pacman314159/3D-Printed-Crane-System-HCMUT/AS2071_CC01_Group_04 (1).pdf

## Ho Chi Minh City of Technology

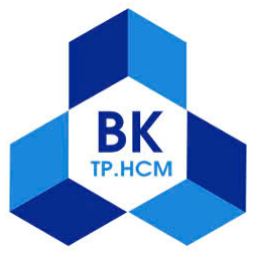
[picture p1: figure]

## Engineering Mechanics – AS2071

## Lecturer: Ph.D. Pham Toan Thang

# Design and Modelize Tower Crane

## Group 04 – CC01

No | STUDENT ID | NAME | TASK | SIGN
1 | 2452911 | Nguyen Quy Hao Nhien | Electrical Design
2 | 2452389 | Luu Gia Huy | Mechanical Design
3 | 2452318 | Nguyen Cat Gia Han | Transmission Design
4 | 2453304 | Hoang Trong Tri | Mechanical Design
5 | 2453259 | Nguyen Duc Toan (LD) | Report Writer
6 | 2452696 | Nguyen Thanh Long | Control Design
7 | 2450001 | Nguyen Minh Quoc Anh | Report Writer

## Dec 01st

, 2025

# Contents

Introduction | 1
1 Mechanism Overview | 2
2 Mechanical Design | 12
3 Transmission Design | 16

i

4 Electrical & Control Design | 24

ii

5 Testing & Evaluation | 35
Conclusion and Evaluation | 39
Reference | 41

iii

# List of Figures

1.1 Tower Crane Structure | | 2
1.2 Base Support (Front view) | | 3
1.3 Base Support (Side view) | | 3
1.4 Tower Section | | 4
1.5 Slewing Ring | | 4
1.6 Operator Cab | | 5
1.7 Main Jib | | 5
1.8 Trolley | | 6
1.9 Hook Block | | 6
1.10 Counter Jib | | 6
1.11 Counterweight | | 7
1.12 Pandent Bars | | 8
1.13 Tower Top | | 8
1.14 Transmission System | | 8
1.15 Slewing Mechanism | 10
2.1 Overview of Mechanical Design | 14
3.1 Visualization of Transmission System | 16
3.2 Visualization of Hoisting Mechanism | 18
3.3 Visualization of Trolley Mechanism | 20
3.4 Visualization of Servo-to-Drum Transmission System | 21
4.1 Electrical-Control Overview 1 | 24
4.2 Electrical-Control Overview 2 | 25
4.3 Electrical-Control Diagram | 25

iv

4.4 Power Unit | 27

v

# Introduction

Tower cranes are indispensable equipment in modern construction, serving as the back-

bone of high-rise building projects and large-scale infrastructure development worldwide. These

machines represent a remarkable achievement in mechanical engineering, combining sophisti-

cated structural design, power transmission systems, and advanced control technology to safely

lift heavy loads at significant heights with precision and efficiency.

The tower crane is a massive vertical lifting structure characterized by its exceptional

reach, high load capacity, and operational stability. A typical tower crane consists of nine major

assemblies: base support, lattice steel tower, rotating turntable, operator’s cabin, main jib,

counter jib, counterweight masses, trolley-and-hook system, and tie cables. These components

work synergistically to achieve safe lifting operations. The design reflects a deep understanding

of mechanical principles, particularly moment equilibrium, force distribution, and structural

stability—concepts fundamental to engineering mechanics.

Understanding the structure and operating principles of tower cranes provides valuable

insights into applied mechanics and mechatronics engineering. By studying how loads are

distributed, how moments are balanced, and how forces are transmitted through mechanical

systems, engineers gain practical knowledge applicable to numerous engineering domains. This

project demonstrates how classical mechanics principles are applied to solve complex engineering

challenges in real-world lifting equipment.

# Chapter 1

# Mechanism Overview

The tower crane is a large-scale lifting and lowering equipment widely used in the con-

struction of high-rise buildings, bridges, roads, and major infrastructure projects. This type of

equipment is capable of extended reach, lifting heavy loads at great heights, while maintaining

stability and operational precision. Studying the structure and mechanical principles of tower

cranes helps clarify how loads are distributed, moments are balanced, and forces are transmit-

ted. This knowledge is essential for modeling, designing, and simulating structures in applied

mechanics and mechatronics engineering.

A typical tower crane consists of nine main assemblies: base support, tower section,

turntable, operator’s cab, main jib, trolley and hook block, counter jib, counterweight, and tie

cables.

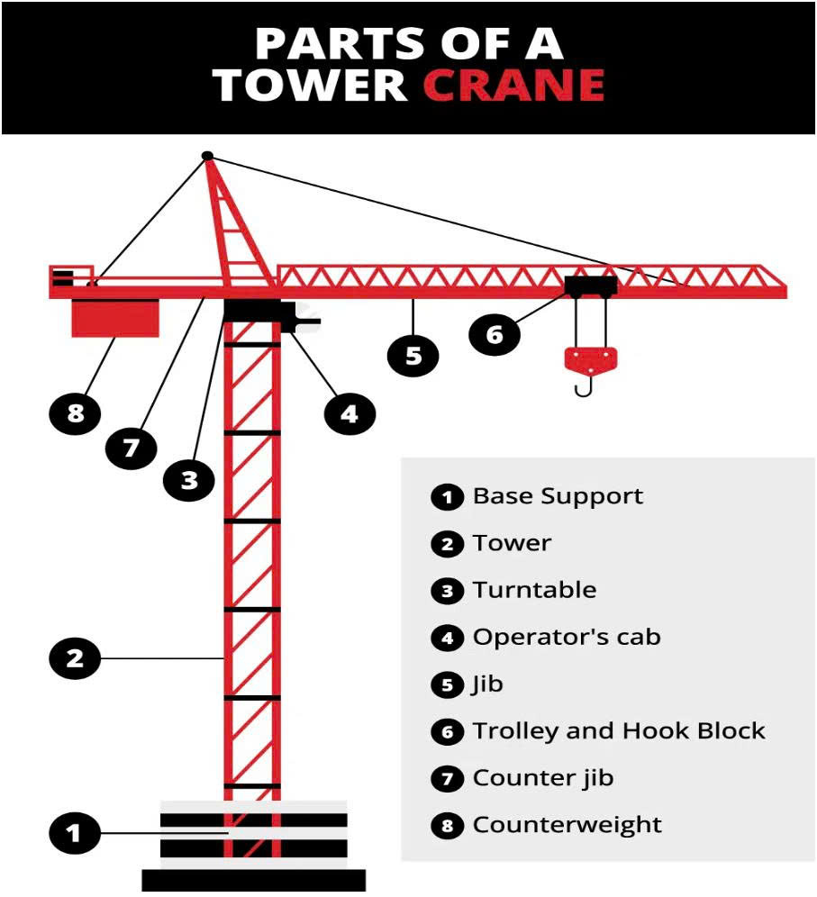
[picture p2: figure]

Figure 1.1: Tower Crane Structure

## 1.1 Tower Crane Structure

### 1.1.1 Base Support

The base support is the foundation component that bears the entire load of the tower

crane and is firmly anchored to reinforced concrete foundations. The structure typically consists

of a welded steel frame arranged in a grid or flange configuration with high-strength bolted

connections. This design distributes compressive forces and bending moments to the ground,

ensuring overall system stability. The choice of a welded lattice structure reduces weight while

maintaining high rigidity, facilitating assembly and disassembly.

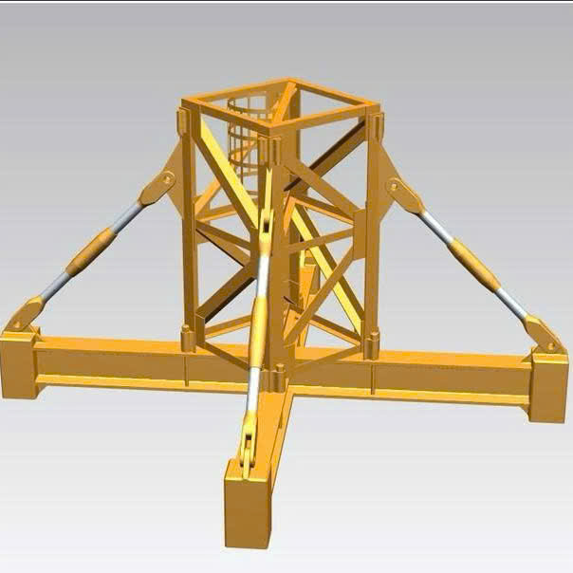
[picture p3: figure]
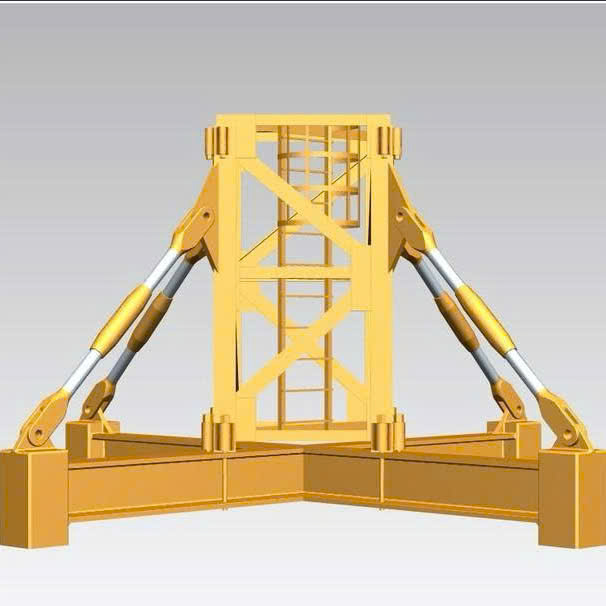
[picture p4: figure]

Figure 1.2: Base Support (Front view) | Figure 1.3: Base Support (Side view)

### 1.1.2 Tower Section

The tower is a spatial steel lattice structure composed of multiple standard sections con-

nected by bolts or pins. Each section consists of main compression members and diagonal

bracing members that experience tension or compression, forming a triangular geometry that

promotes uniform force distribution, resists torsion, and prevents longitudinal bending. This

structure allows the tower to reach heights of tens of meters while remaining lightweight and sta-

ble. The diagonal bracing is arranged in a triangular pattern because this geometry is inherently

stable, reducing overall deformation when subjected to wind loads or eccentric loads.

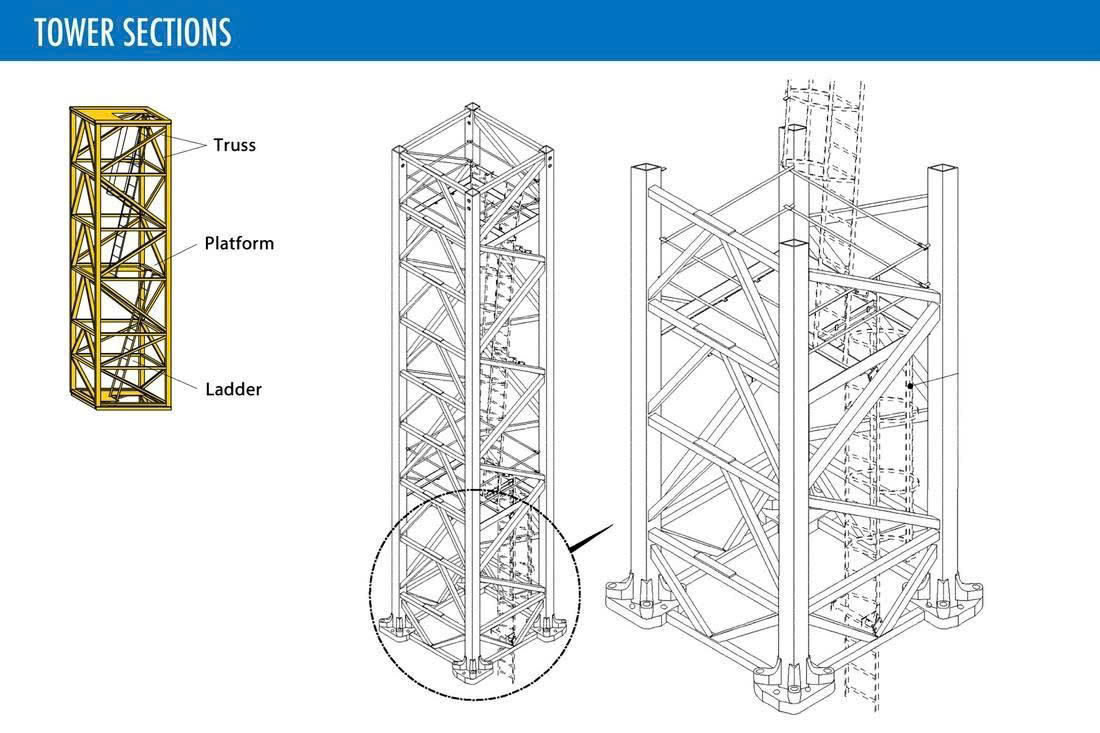
[picture p5: figure]

Figure 1.4: Tower Section

### 1.1.3 Turntable (Slewing Ring)

The turntable or slewing ring is an assembly positioned at the top of the tower, featuring

a low-friction bearing mechanism that allows the entire upper portion to rotate 360°. This

component transmits the rotational moment from the motor to the jib. The turntable structure

is designed with a large ring bearing with internal teeth, enabling it to withstand large bending

moments while operating smoothly when loads change. This design ensures flexibility during

lifting and material handling operations.

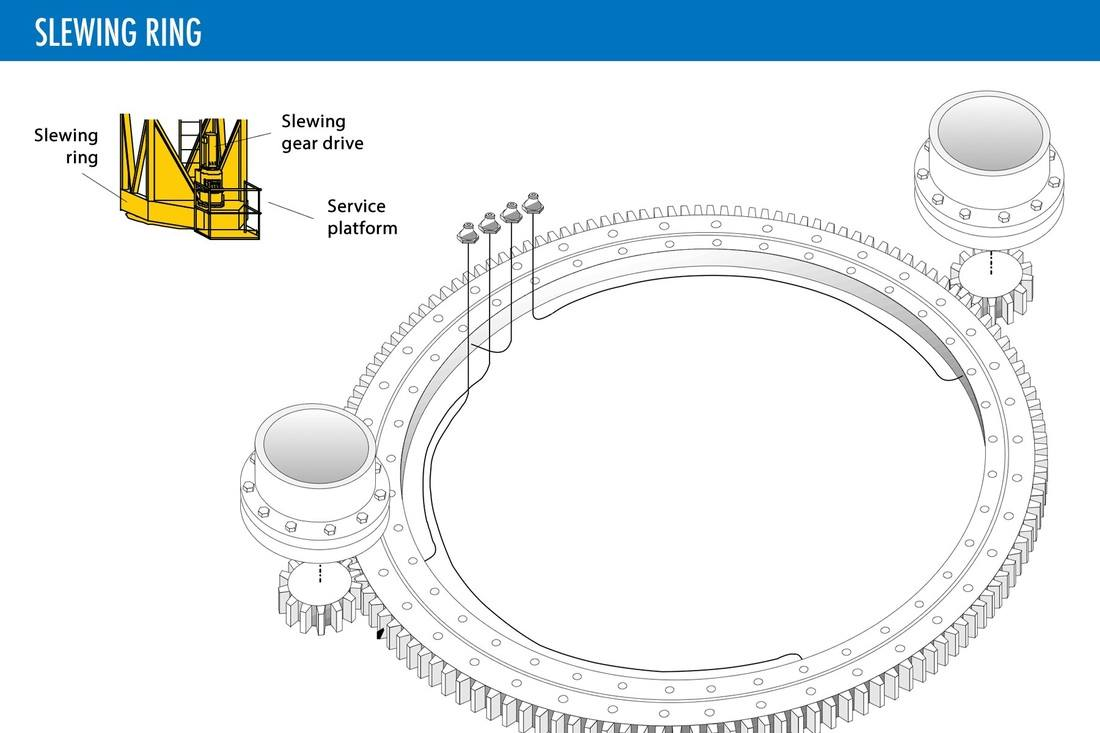
[picture p6: figure]

Figure 1.5: Slewing Ring

### 1.1.4 Operator’s Cab

The operator’s cab is where the crane operator observes and controls all crane operations.

It is constructed from lightweight load-bearing steel, features reinforced glass windows, and is positioned near the center of rotation to minimize vibration. This design placement provides

the operator with an optimal viewing angle of the work area while reducing the sensation of

swaying caused by inertial moments when the tower rotates.

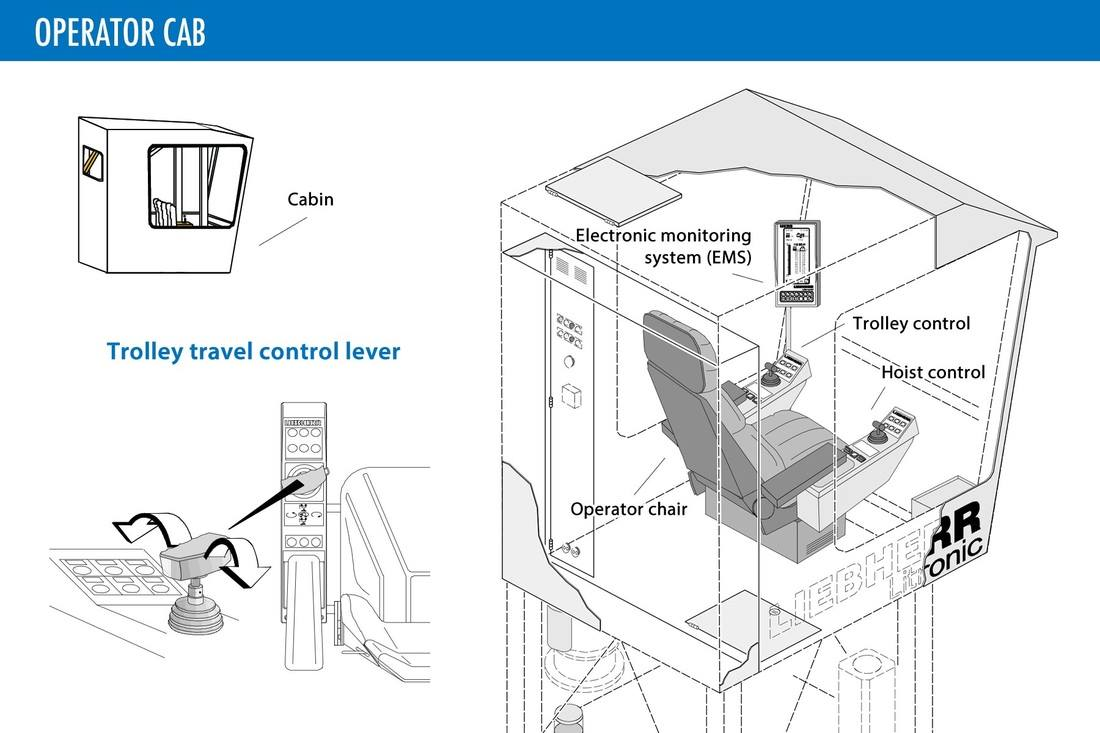
[picture p7: figure]

Figure 1.6: Operator Cab

### 1.1.5 Main Jib

The main jib is the extending component that reaches forward to carry loads and move

materials within the working radius. It is typically manufactured from welded structural steel or

diagonal lattice steel to reduce weight while maintaining rigidity. The triangular lattice design

on the jib distributes tension and compression forces evenly across members, increasing bending

strength and preventing excessive deflection. The main jib is installed at a slight angle to reduce

the torsional moment acting on the tower.

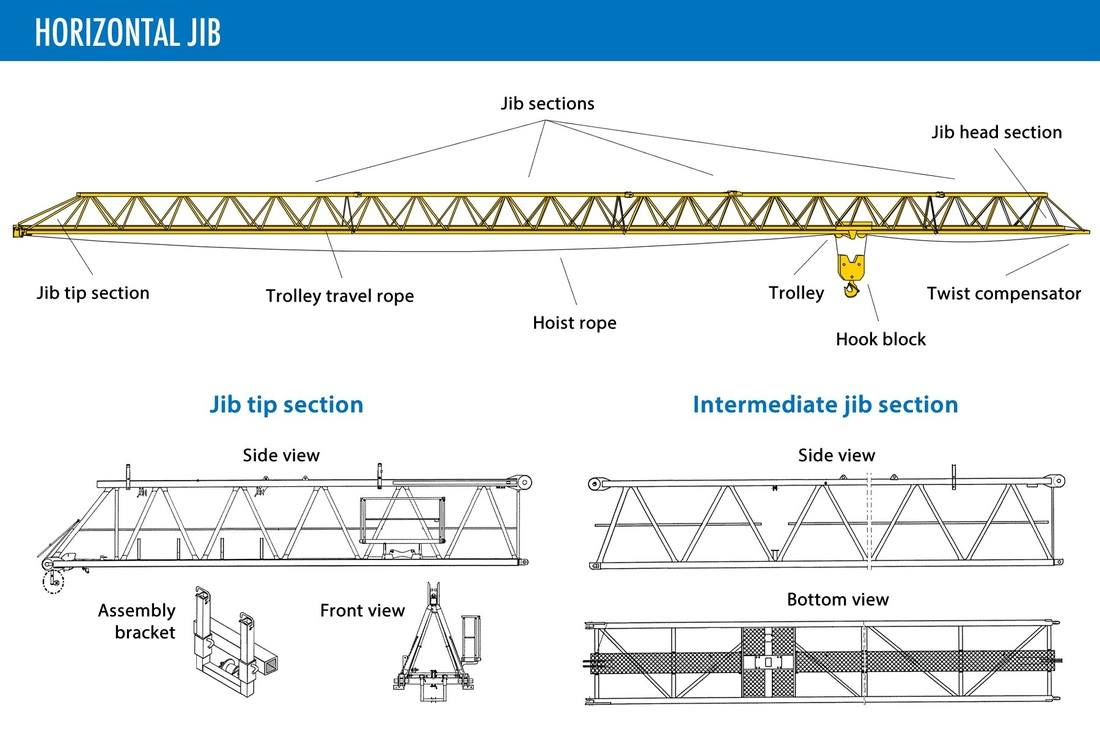
[picture p8: figure]

Figure 1.7: Main Jib

### 1.1.6 Trolley and Hook Block

The trolley travels along the main jib and carries the hook block through a system of

pulleys and steel wire ropes. This component allows adjustment of the suspension position,

increasing operational flexibility during lifting and lowering. The hook block system typically

features a multi-sheave pulley arrangement to distribute the load, reducing cable tension and

thus extending cable life while ensuring safety during heavy lifting.

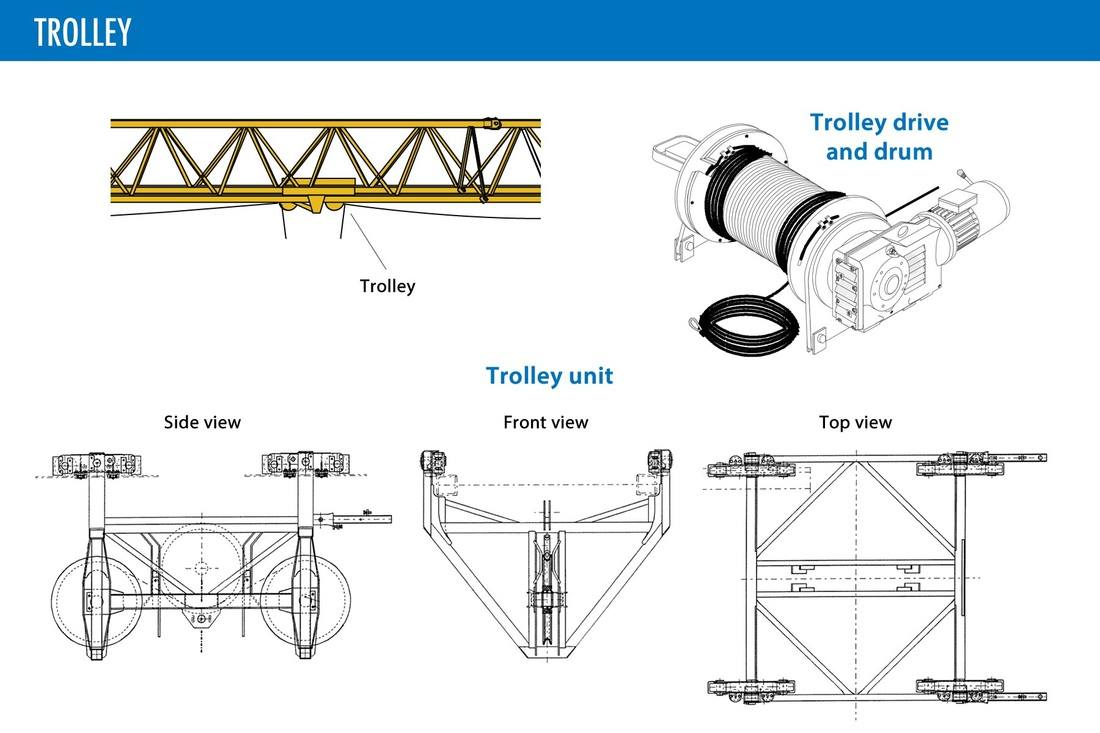
[picture p9: figure]
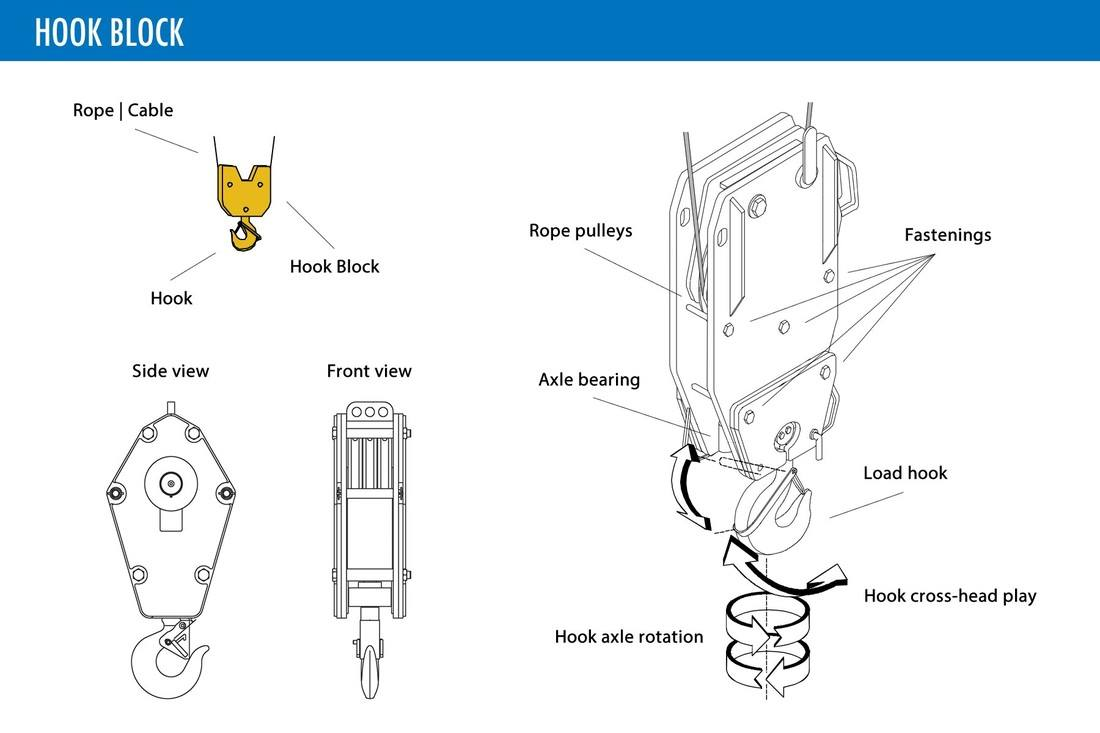
[picture p10: figure]

Figure 1.8: Trolley | Figure 1.9: Hook Block

### 1.1.7 Counter Jib

The counter jib is a shorter extending arm that reaches backward behind the tower to

balance the moment created by the main jib. This arm typically supports the lifting motor,

cable systems, and concrete or steel counterweights. The counter jib structure is engineered

so that its moment counteracts the moment created by the load at the end of the main jib,

ensuring the tower remains stable under all working conditions.

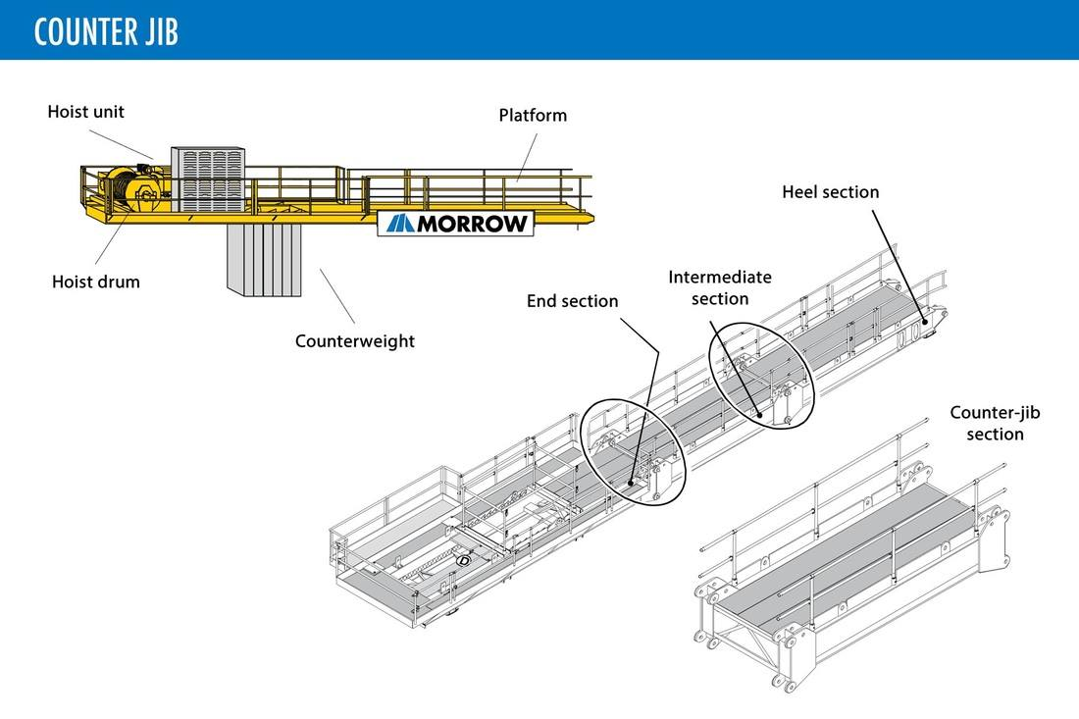
[picture p11: figure]

Figure 1.10: Counter Jib

### 1.1.8 Counterweight

Counterweights are solid concrete or steel blocks permanently attached to the end of the

counter jib. The mass of the counterweight is carefully calculated based on the maximum load

of the crane and the length of the main jib. Positioning the counterweight at the rear reduces

the load on the turntable bearing, maintains balance for the entire system, and prevents crane

tip-over. This design is critical to maintaining both static and dynamic balance of the tower

crane.

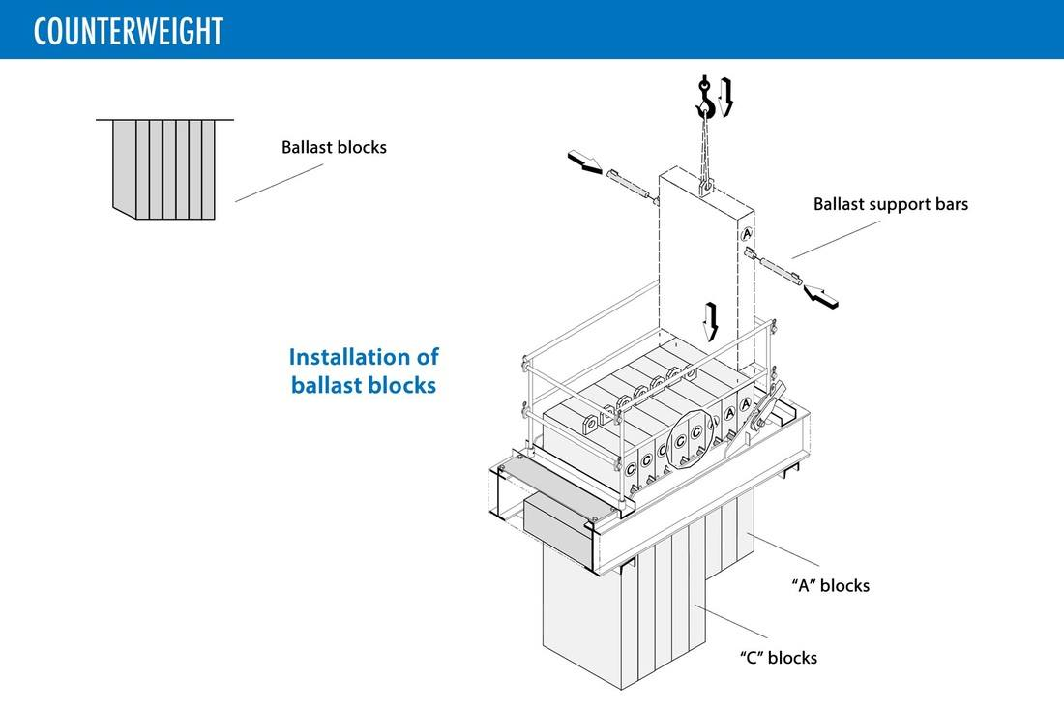
[picture p12: figure]

Figure 1.11: Counterweight

### 1.1.9 Tie Cables and Top Crane (Pendant Bars)

Tie cables are a system of high-strength steel wire ropes under tension, connecting from

the top of the tower to both ends of the main jib and counter jib. These cables transmit force

and maintain the geometric stability of the entire structure. Cables are manufactured from

high-strength steel in multiple twisted layers to withstand large tensile forces and resist fatigue

from wind-induced vibrations. During operation, when the main jib carries a load, the tie cables

experience tensile force, forming a balanced force triangle between the tower, jibs, and cables,

significantly reducing bending moments on the tower and limiting deformation. The positioning

of tie cables on both sides allows uniform distribution of moments between the two jibs, keeping

the tower vertical and stable. This design reduces the weight of the upper structure, conserves

materials, maintains high rigidity, and facilitates installation, adjustment, and maintenance,

resulting in optimal mechanical and economic efficiency for the entire tower crane system.

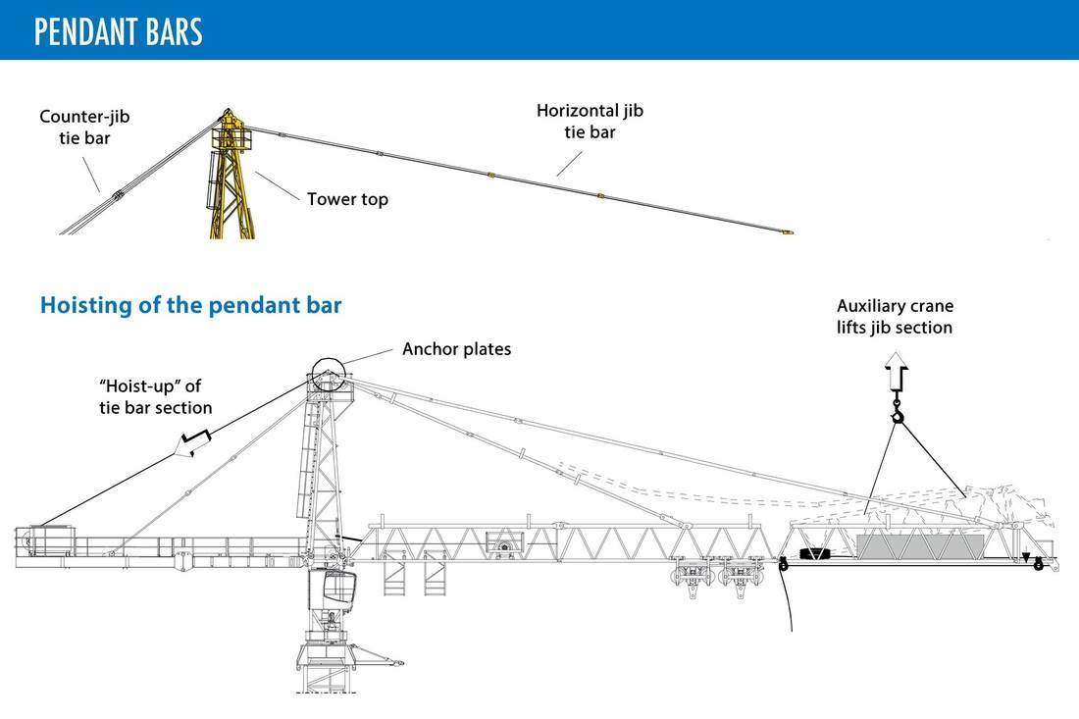
[picture p13: figure]
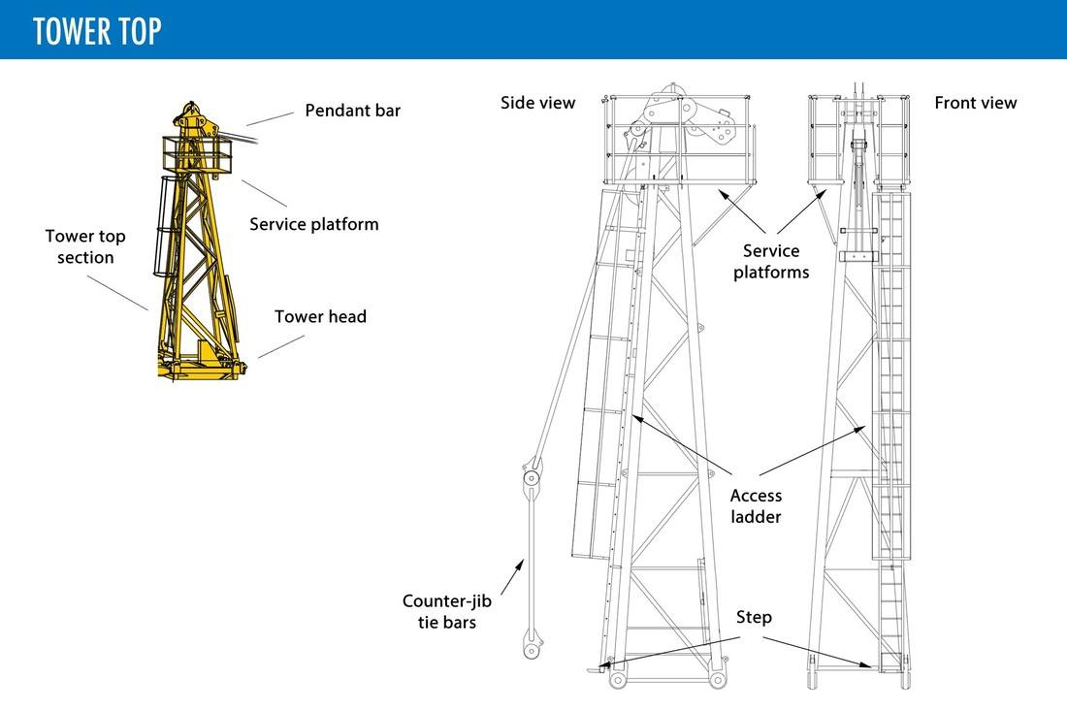
[picture p14: figure]

Figure 1.12: Pandent Bars | Figure 1.13: Tower Top

## 1.2 Operating Principle

The operating principle of a tower crane is based on four fundamental mechanisms: hoist-

ing and trolley translation mechanism, slewing mechanism, and load balancing mechanism.

### 1.2.1 Hoisting and Trolley Translation Mechanism

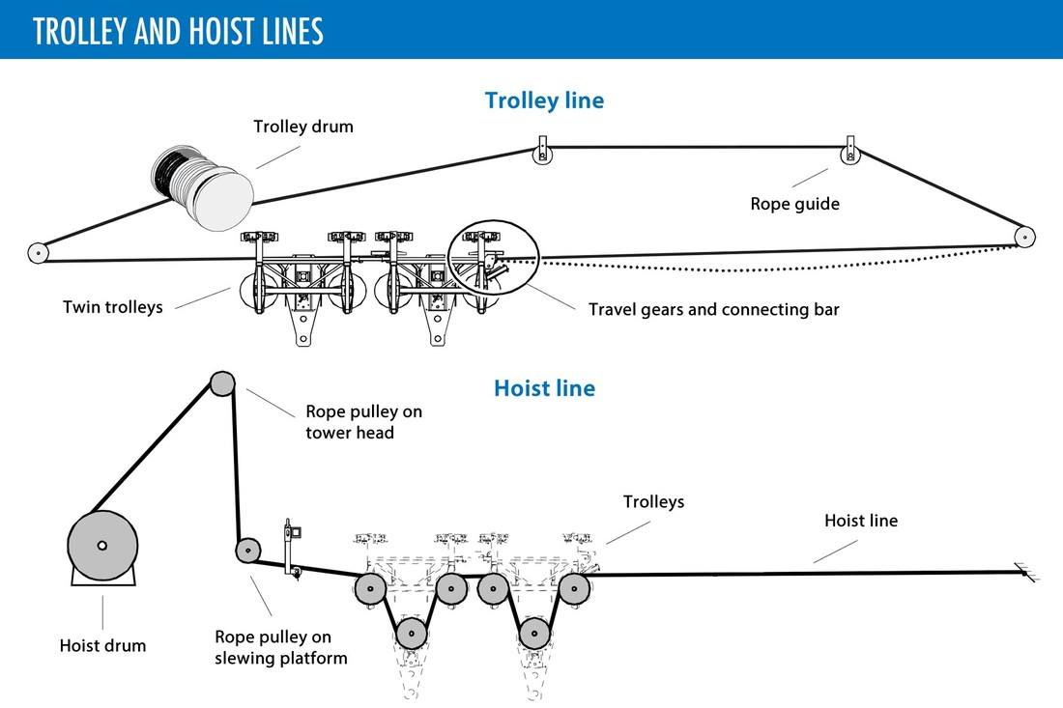
[picture p15: figure]

Figure 1.14: Transmission System

Hoisting Mechanism

The hoisting mechanism operates on a system of winches, pulleys, and steel wire ropes

designed to amplify the motor’s pulling force into large lifting forces capable of raising heavy

loads to significant heights. The hoisting motor transmits torque to the hoist drum, and steel

wire ropes run through guide pulleys along the main jib and down to the hook block, forming

a multi-sheave pulley system that distributes the load, reduces cable tension, and improves mechanical efficiency. When the motor rotates, the drum winds or unwinds the cable, causing

the hook block to move upward or downward.

The design ensures that the lifting force acts primarily in the vertical direction, dis-

tributing the load evenly across the tower and jib structure, minimizing eccentric moments

and vibrations. This mechanism is enhanced by speed regulation systems and electromagnetic

brakes, enabling smooth, precise, and safe hoisting and lowering operations. Consequently,

tower cranes can raise heavy loads at heights of tens of meters while maintaining structural

balance and integrity. The relationship between motor torque, drum radius, and cable tension

can be expressed as:

Flift =

τmotor · n

rdrum

where Flift is the lifting force, τmotor is the motor torque, n is the number of cable strands,

and rdrum is the hoist drum radius.

### 1.2.2 Load Balancing Mechanism

The load balancing mechanism in a tower crane is based on the principle of moment equi-

librium about the tower’s rotation axis. When the main jib carries a load, it generates a tipping

moment directed forward. The counter jib, positioned behind the tower and equipped with con-

crete or steel counterweights, generates an opposing moment to keep the tower upright. These

two moments are calculated such that the net moment about the rotation axis is minimized,

allowing the crane to maintain balance under all working conditions.

Additionally, the tie cable system connecting the tower top to the ends of both the main

jib and counter jib distributes tension and compression forces uniformly, reducing stress on

the tower structure and enhancing overall stability. The moment balance principle can be

mathematically expressed as:

Mjib = Mcounter + Mtie

where Mjib is the moment created by the main jib load, Mcounter is the moment from the

counterweight, and Mtie is the stabilizing moment from the tie cables. For equilibrium:

Mjib ≈ Mcounter

### 1.2.3 Slewing Mechanism

The slewing mechanism operates on the principle of transmitting rotational torque from

the slewing motor to the turntable positioned at the tower top, enabling the upper structure

to rotate 360° around the vertical axis. Specifically, the slewing motor transmits force through

a gearbox to a pinion gear that meshes with a large ring gear attached to the turntable, pro-

ducing smooth and stable rotational motion. The bearing system and low-friction slewing ring

support the turntable load while withstanding the large moments generated when the jib carries

loads. Typical slewing speeds range from 0.5 to 2 revolutions per minute (rpm), controlled by

variable frequency drives to adjust rotation speed and direction, ensuring precise operation and

preventing jerking movements. The angular velocity can be calculated from:

ω =

2πn
60

where ω is angular velocity in rad/s and n is the rotation speed in rpm.

Figure 1.15: Slewing Mechanism

### 1.2.4 Trolley Translation Mechanism

The trolley translation mechanism operates on the principle of mechanical power trans-

mission from the trolley motor to the trolley assembly that travels along the main jib, enabling

horizontal load positioning. The motor, positioned at the jib end or on the trolley itself, trans-

mits force through gear systems, belt drives, or cable systems, causing the trolley to slide along

guide rails. As the trolley moves away from the tower, the load shifts outward, increasing

the tipping moment; conversely, as the trolley moves toward the tower, the moment decreases,

allowing flexible load balancing during heavy lifting operations. This system typically incorpo-

rates braking mechanisms and travel limit sensors to ensure safety and prevent collisions at jib

ends.

The relationship between trolley position and system moment can be expressed as:

Mtotal = W · d

Where Mtotal is the total moment, W is the load weight, and d is the horizontal distance

from the load to the tower axis. By adjusting the trolley position, operators can maintain

moment equilibrium:

W · djib = mcounter · g · dcounter

where mcounter is the counterweight mass, g is gravitational acceleration, djib is the load

distance from tower axis, and dcounter is the counterweight distance.

# Chapter 2

# Mechanical Design

## 2.1 Mechanical Components

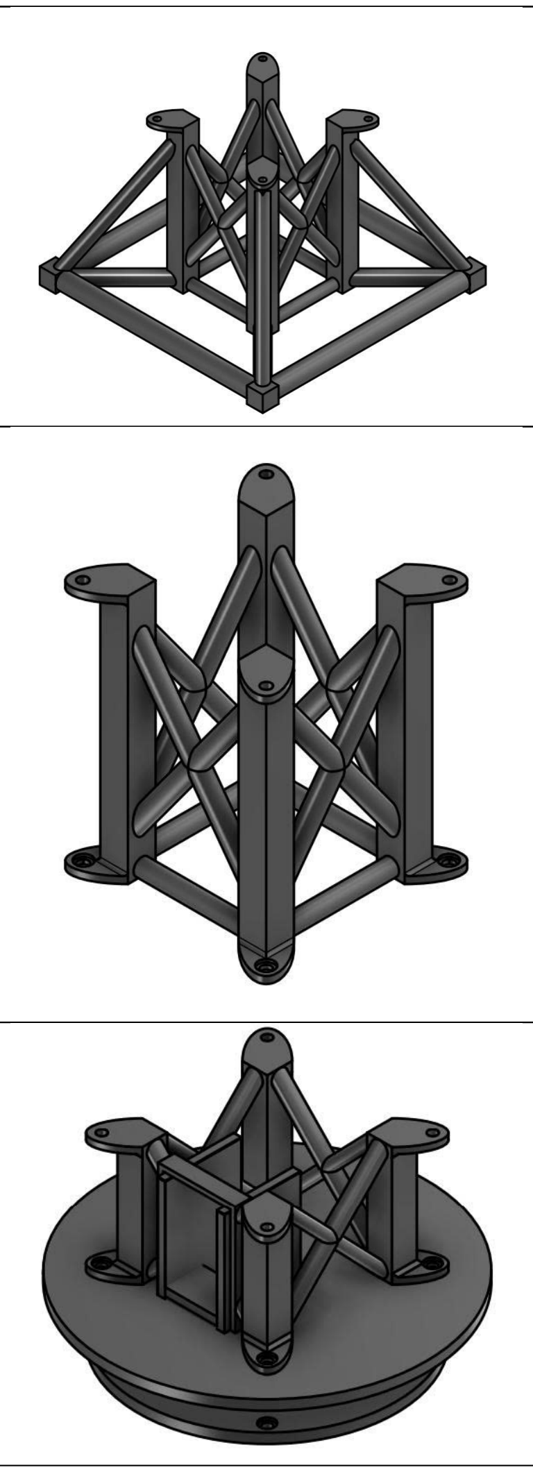
[picture p16: figure]

1. Base Support Description: Reinforced steel lattice framework anchoring the tower to a concrete foundation, distributing all loads to the ground.
2. Tower Section Description: Modular steel lattice with vertical members and diagonal bracing, stacked to achieve the required height and rigidity.

3-4. Slewing Unit Description: Precision bearing assembly enabling 360-degree rotation and transmitting motor torque through internal teeth engagement.

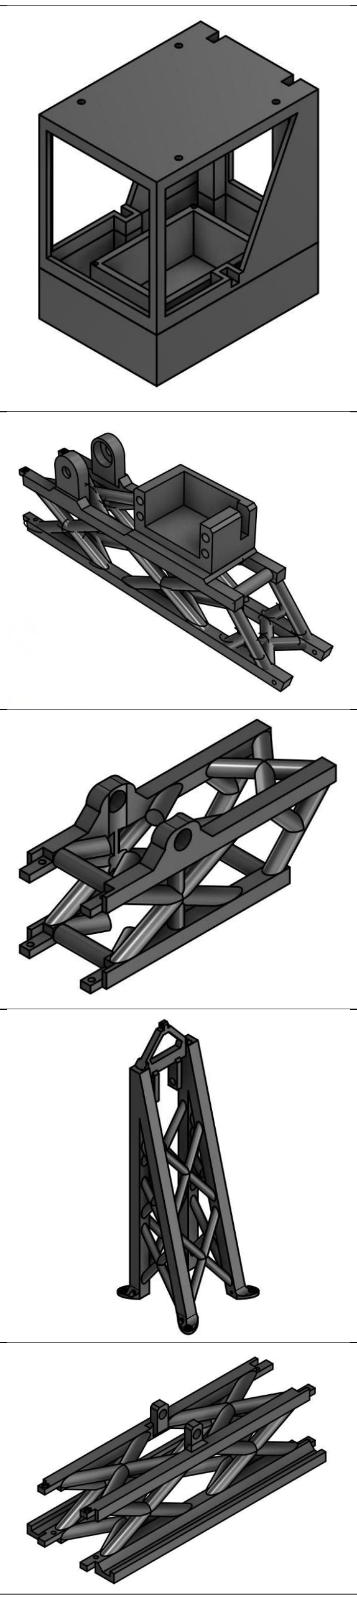
[picture p17: figure]

5. Operator Cabin Description: Cabin providing the operator with optimal visibility of the work area and control circuit housing.
6. Jib (Connector) Description: Connection bracket housing servo drive mo-tor—the ”heart” of the transmission system. Transmits all jib loads and drive forces to the slewing ring.
7. Jib (Counterweight) Description: Rear arm carrying counterweight masses. Reduces weight through hollow sections while balancing the main jib load moment.
8. Top Tower Description: Upper assembly housing, slewing bearing, and drive mechanism. Supports jib attachment and dis-tributes loads to the tower, preventing jib tilting with drive support.
9. Jib (Pulley) Description: Jib section with integrated pulley system connected to the top tower. Routes hoist cables with a symmetrical load distribution design.

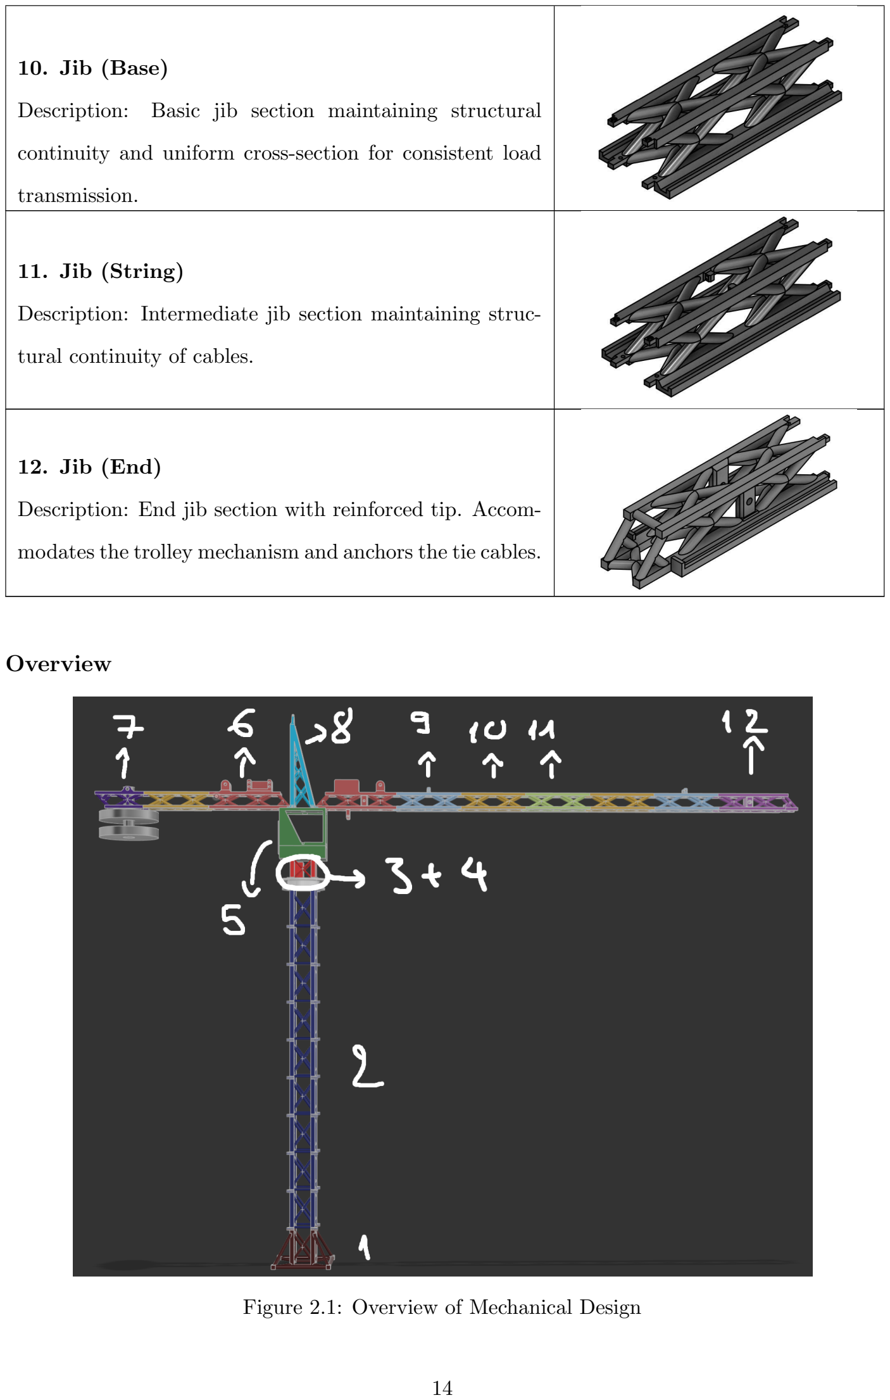
[picture p18: page 20]

10. Jib (Base) Description: Basic jib section maintaining structural continuity and uniform cross-section for consistent load transmission.
11. Jib (String) Description: Intermediate jib section maintaining struc-tural continuity of cables.
12. Jib (End) Description: End jib section with reinforced tip. Accom-modates the trolley mechanism and anchors the tie cables.

Overview

Figure 2.1: Overview of Mechanical Design

## 2.2 Principle Explanation

Load Distribution

When the load is suspended, the vertical force propagates through the hoist cable to the

jib pulley. The jib connector, housing servo motor, serves as the primary load hub and moment

distribution point:

Mjib = W · djib

where W is load weight and djib is horizontal distance from rotation axis.

Load Balancing

The rear jib with counterweight creates an opposing moment. System equilibrium re-

quires:

Mjib ≈ Mcounter = mc · g · dc

This ensures stability regardless of load position along the main jib.

The top tower prevents jib tilting by providing vertical support at the pulley connection.

Reinforced jib base transfers forces to the slewing bearing with minimal deformation. Jib end

section anchors tie cables and accommodates the trolley mechanism.

Dynamic Equilibrium

All system components work synergistically to maintain moment balance:

Mtotal = Mjib − Mcounter − Msupport ≈ 0

This equilibrium enables safe load handling at various positions.

# Chapter 3

# Transmission Design

## 3.1 Overview of Transmission Systems

A tower crane is a complex mechanical system designed to perform multiple coordinated

motions to lift and transport loads efficiently within a construction site. Its overall operation

is achieved through several independent transmission mechanisms, each responsible for a spe-

cific type of movement. A tower crane incorporates four fundamental motions, supported by

dedicated transmission subsystems:

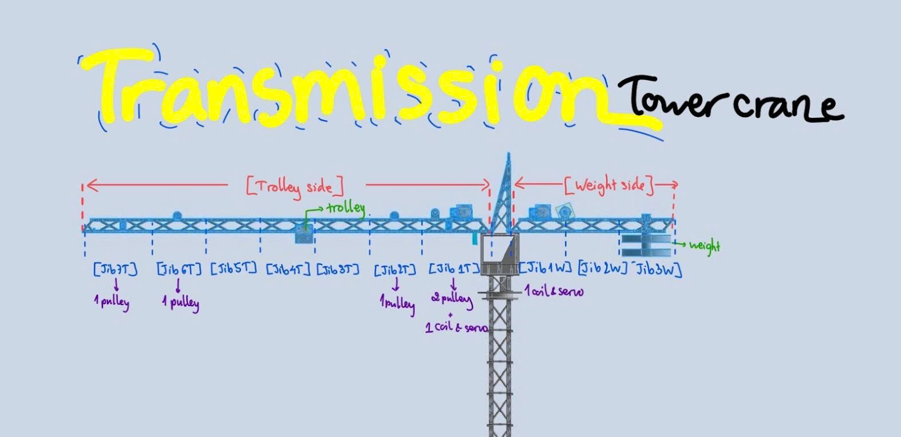
[picture p19: figure]

Figure 3.1: Visualization of Transmission System

- Slewing Mechanism: Enables the jib to rotate about the vertical axis, allowing the

crane to cover a wide working radius and position loads at any angular direction.

- Hoisting (Lifting) Mechanism: Provides vertical motion along the mast through con-

trolled wire rope actuation, enabling loads to be raised or lowered with precision.

- Trolley Travel Mechanism: Produces horizontal motion along the jib, adjusting the

load’s horizontal distance from the tower and enabling precise radial positioning.

- Servo-to-Drum Transmission System: Converts servo motor rotational motion into

controlled cable actuation, supporting load synchronization and accurate motion feedback.

These four motions work synergistically to ensure precise load positioning and efficient

material handling. The design of their transmission systems is critical to overall crane perfor-

mance, safety, and reliability.

## 3.2 Slewing Mechanism

### 3.2.1 Operating Principle

The slewing mechanism enables the jib and upper structure to rotate about the vertical

axis using a servo motor coupled to the slewing bearing. The MG995R 360-degree servo mo-

tor provides continuous rotation capability, with torque transmitted through the slewing ring

bearing to rotate the entire upper assembly.

### 3.2.2 Torque and Speed Calculations

Motor Torque Output

The MG995R servo motor generates a maximum torque of:

τmotor = 9.4 kg·cm = 0.94 N·m

At rated voltage (6V), the motor can sustain this torque continuously during slewing

operations.

Angular Velocity

The no-load motor speed is 60 rpm. Converting to rad/s:

ωmotor =

60 rpm × 2π
60 s

= 2π rad/s ≈ 6.28 rad/s

For the slewing mechanism, the actual turntable rotation speed depends on the gear

reduction ratio ir between the motor and slewing bearing:

ωturntable =

ωmotor
ir

With typical reduction ratios of 30:1 to 50:1, the turntable rotates at:

nturntable =

60 rpm
ir

=

60
40

≈ 1.5 rpm (for ir = 40)

Available Torque at Turntable

The torque available at the turntable, accounting for mechanical efficiency (η ≈ 0.85):

τturntable = τmotor × ir × η = 0.94 × 40 × 0.85 ≈ 31.96 N·m

This torque is sufficient to overcome the overturning moment created by the suspended

load on the jib.

## 3.3 Hoisting Mechanism

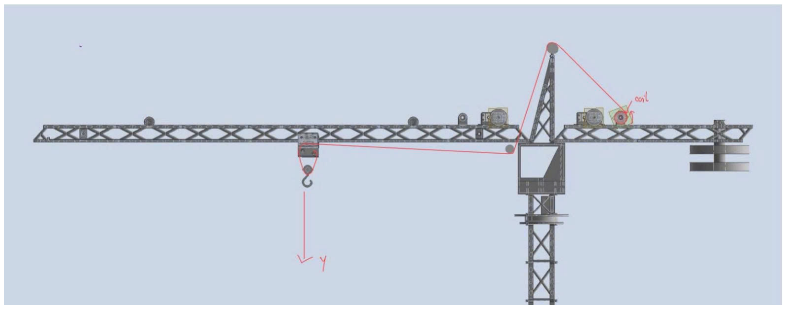
[picture p20: figure]

Figure 3.2: Visualization of Hoisting Mechanism

### 3.3.1 Operating Principle

The hoisting mechanism converts rotational motion from the hoisting motor into con-

trolled vertical movement of the hook block. The wire rope is wound onto a hoisting drum

(coil) positioned on the counter-jib. When the motor rotates the drum in the winding direction,

the rope shortens, and the hook is raised vertically. Conversely, when the drum rotates in the

unwinding direction, the rope length increases and the hook is lowered.

The rope path follows a predetermined route: starting from the hoisting drum, it passes

over a guide sheave at the top of the tower mast, then runs along the jib toward the trolley.

At the trolley location, the rope is redirected downward through pulleys in the hook block.

This arrangement ensures smooth load motion and distributes tension effectively throughout

the structure.

### 3.3.2 Load Distribution and Mechanical Advantage

The coordinated interaction between the hoisting drum, sheaves, and multi-sheave hook

block creates a mechanical advantage system. The multiple pulley arrangement reduces cable

tension and load on individual rope strands, extending rope life and improving safety margins.

The lifting force can be expressed as:

Flift =

Tmotor · n

rdrum

where Tmotor is motor torque, n is the number of supporting rope strands, and rdrum is the

hoist drum radius. This configuration enables the crane to lift loads with precision, stability, and

controlled speed, while minimizing dynamic loads during acceleration and deceleration phases.

## 3.4 Trolley Travel Mechanism

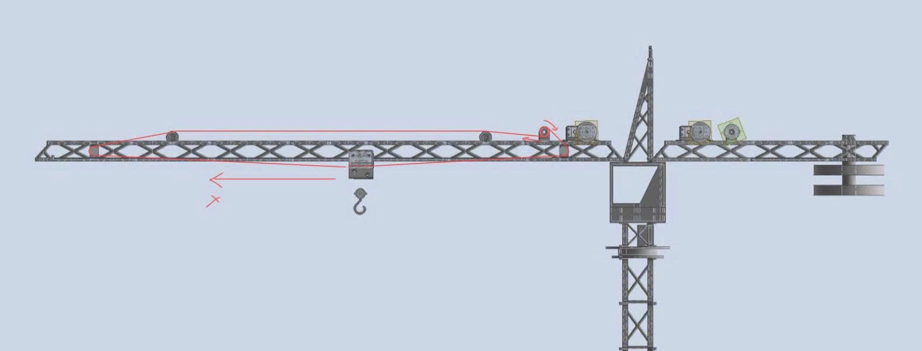
[picture p21: figure]

Figure 3.3: Visualization of Trolley Mechanism

### 3.4.1 Operating Principle

The trolley travel mechanism provides horizontal motion along the jib, allowing the load

to be positioned at different radii from the tower mast. The trolley is actuated by a wire

rope driven by a dedicated travel motor and drum located near the tower base. When the

motor winds the rope onto the drum, the trolley is pulled toward the mast (inward direction).

Conversely, when the drum unwinds the rope, the trolley moves outward toward the jib tip.

The wire rope is routed through a series of guide pulleys positioned along the jib to

maintain proper alignment and tension. These pulleys redirect the rope path, ensuring smooth

trolley movement and preventing lateral oscillations during operation. The system enables

precise, bidirectional motion along the horizontal axis, coordinating with the lifting mechanism

to position loads accurately within the working radius.

### 3.4.2 Motion Control and Load Balancing

As the trolley moves, the horizontal distance d between the load and the tower axis

changes, directly affecting the system moment:

Mtotal = W · d

Operators adjust the trolley position to maintain moment equilibrium:

W · djib = mcounter · g · dcounter

This dynamic adjustment capability is essential for safe load handling across the entire

working envelope of the crane.

## 3.5 Servo-to-Drum Transmission System

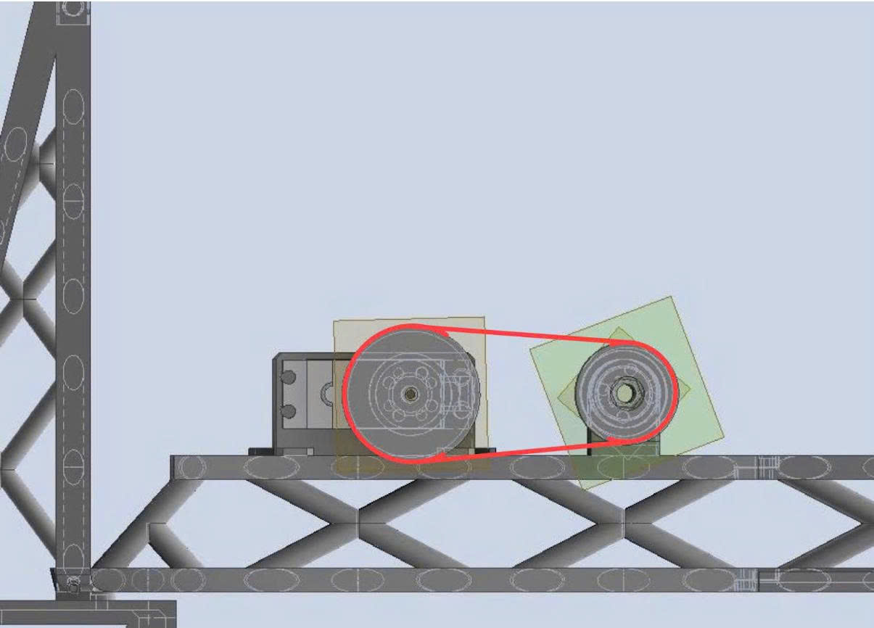
[picture p22: figure]

Figure 3.4: Visualization of Servo-to-Drum Transmission System

### 3.5.1 Design Alternatives and Selection Criteria

In selecting the transmission method for the servo-to-drum system, three primary alter-

natives were evaluated: a gearbox, a conventional belt drive, and a wire rope with a two-pulley

arrangement. Each option offers distinct mechanical characteristics, installation requirements,

and operational performance. The following comparative assessment was conducted to select

the most appropriate solution.

Gearbox Transmission

A gearbox provides high torque transmission capability and precise speed reduction through

multiple gear stages. However, this approach introduces significant mechanical complexity, re-

quiring multiple gears, bearings, lubrication systems, and sealed housings to prevent contami-

nation. The resulting design is characterized by:

- Higher weight and increased inertia
- Elevated manufacturing and assembly costs

- More demanding maintenance and lubrication procedures
- Larger overall footprint in space-constrained regions

For a lightweight trolley travel mechanism where compactness and system simplicity are

prioritized, a gearbox is unnecessarily complex.

Belt Drive Transmission

A standard belt drive represents a simpler alternative offering flexible mounting, low

noise operation, and effective vibration-damping characteristics. However, belt systems present

inherent limitations:

- Require adjustable slots or external tensioners for tension maintenance
- Performance is sensitive to pulley alignment and belt wear
- Demand periodic inspection and replacement of worn belts
- Introduce potential reliability concerns in constrained access environments

While simpler than gearboxes, belt drives still require supplementary tensioning compo-

nents and regular maintenance monitoring.

Wire Rope with Two-Pulley System

The wire rope with a two-pulley arrangement presents a balanced and efficient solution

optimized for this application. This system is characterized by:

- Straightforward construction requiring only two pulleys and rope
- Large contact angle between rope and pulleys, enabling natural tension maintenance
- No auxiliary tensioning components necessary
- Reduced mechanical complexity and lower overall system weight
- Flexibility that absorbs vibration and minimizes shock loads on the servo motor
- Simplified assembly, adjustment, and maintenance procedures

### 3.5.2 Selected Configuration

The wire rope with a two-pulley system was selected as the transmission method for the

servo-to-drum interface. This configuration offers the optimal balance of simplicity, reliability,

ease of integration, and reduced maintenance requirements, making it well-suited to the compact

and lightweight design constraints of the tower crane trolley mechanism. The system provides

adequate torque transmission while maintaining operational efficiency and minimizing long-term

maintenance burden.

# Chapter 4

# Electrical & Control Design

## 4.1 System Overview

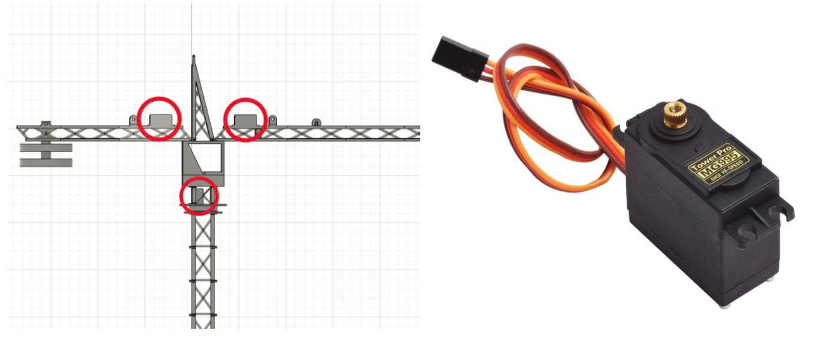
[picture p23: figure]

Figure 4.1: Electrical-Control Overview 1

The electrical and control system forms the operational core of the tower crane, enabling

precise, reliable wireless control of three independent motion mechanisms. The system archi-

tecture comprises two primary subsystems that communicate wirelessly using the ESP-NOW

protocol:

- Crane Main Controller (Receiver): Mounted within the crane’s lower cabin, this

unit directly controls the servo actuators and manages power distribution to all onboard

systems.

- Remote Transmitter (Handheld Controller): A portable unit that captures operator

inputs and wirelessly transmits command packets to the crane.

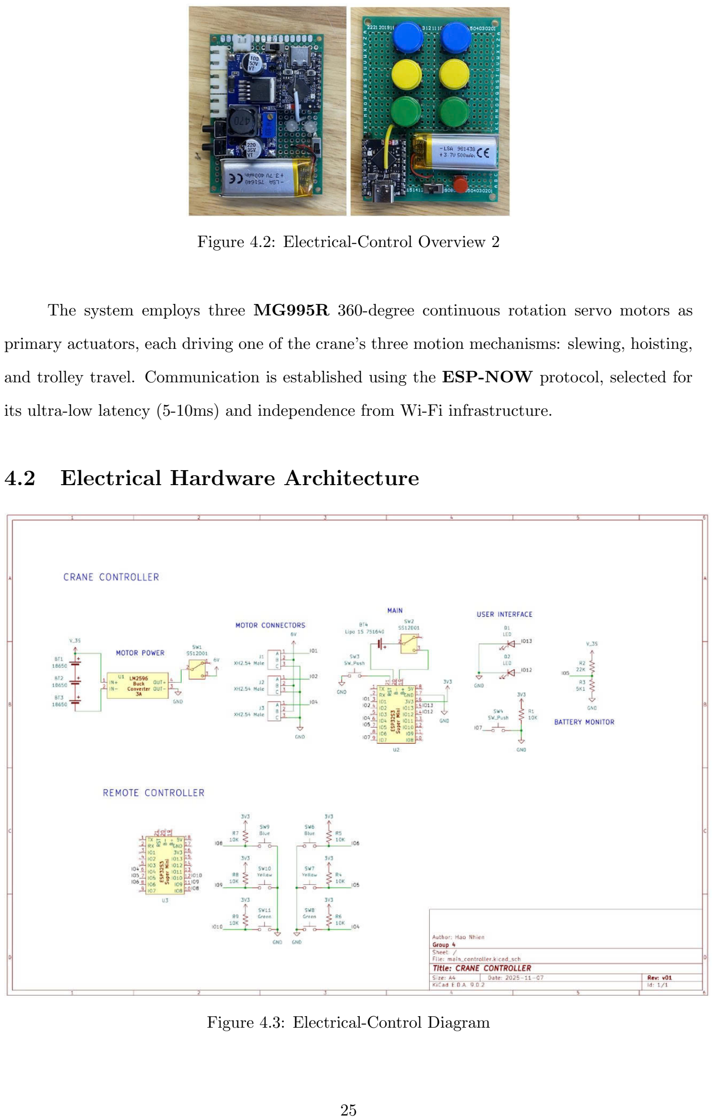
[picture p24: page 31]

Figure 4.2: Electrical-Control Overview 2

The system employs three MG995R 360-degree continuous rotation servo motors as

primary actuators, each driving one of the crane’s three motion mechanisms: slewing, hoisting,

and trolley travel. Communication is established using the ESP-NOW protocol, selected for

its ultra-low latency (5-10ms) and independence from Wi-Fi infrastructure.

## 4.2 Electrical Hardware Architecture

Figure 4.3: Electrical-Control Diagram

### 4.2.1 Crane Main Controller

The Main Controller is housed within a weatherproof enclosure mounted on the crane

structure. It serves as the operational ”brain” of the system, integrating multiple functional

subsystems:

Microcontroller Unit (MCU)

The system employs the ESP32-S3 Super Mini, a compact yet powerful microcontroller

selected for its suitability to this application:

- Processing Power: Xtensa® dual-core 32-bit LX7 microprocessor operating at up to

240 MHz.

- Wireless Connectivity: Integrated 2.4 GHz Wi-Fi and Bluetooth 5 (LE), with native

ESP-NOW protocol support.

- Form Factor: Ultra-compact dimensions (22.52 × 18 mm), facilitating compact circuit

board design.

- Peripherals: Extensive GPIO, PWM, SPI, UART, I2C, and remote control capabilities.
- Battery Management: Onboard single-cell LiPo battery charger and monitoring circuit.

Dual-Source Power Distribution

To prevent microcontroller resets caused by voltage sags from high-current motor draws,

the power system employs two isolated sources:

- Logic Power (MCU Supply): A single 1S lithium polymer (LiPo) cell (3.7V nominal,

3.0-4.2V range) directly powers the ESP32-S3 via its integrated charging circuit.

- Actuator Power (Motor Supply): Three 18650 lithium-ion cells connected in series

(11.1V nominal, 10.2-12.4V range). This high voltage is regulated down to 6V using an

LM2596 Buck Converter (rated for 3A output) to safely drive the servo motors.

This power architecture ensures that high-current motor transients do not cause brownouts

or resets on the microcontroller, maintaining communication stability throughout operation.

Battery Monitoring Circuit

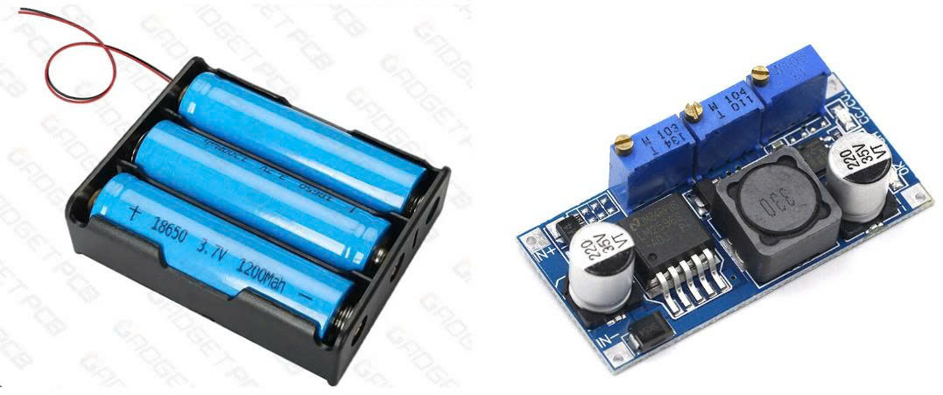
[picture p25: figure]

Figure 4.4: Power Unit

A resistive voltage divider (R2, R3) monitors the high-voltage actuator battery using the

ESP32’s analog input (limited to 3.3V maximum). The resistor values are calculated to scale

12.4V down to approximately 2.33V safely:

Vmeasured = Vbattery ×

R3
R2 + R3

= 12.4 ×

5.1kΩ
22kΩ + 5.1kΩ

≈ 2.33V

When the battery voltage drops to 11.1V, the measurement falls to approximately 2.09V.

This 2.09-2.33V range remains safely within the 0-3.3V operating window of the ESP32’s analog

pins, enabling accurate battery level monitoring.

User Interface and Connectors

- User Interface: Integrated reset buttons, mode switches, and LED indicators provide

visual system status feedback and manual control options.

- Motor Connectors: Standard XH2.54 mm male connectors (commonly available in

commercial markets) are employed for rapid servo motor connection and disconnection,

facilitating modular assembly and maintenance.

- Power Distribution: Separate XH2.54 mm connectors for the high-voltage motor power

bus ensure proper current distribution and prevent accidental cross-connections.

### 4.2.2 Remote Transmitter

The Remote Transmitter unit is the user interface device, built around an identical

ESP32-S3 Super Mini microcontroller to maintain firmware compatibility and simplify de-

ployment.

- Input Devices: Six tactile push-buttons arranged for convenient operation, correspond-

ing to bidirectional control of three mechanisms (Slewing CW/CCW, Hoisting Up/Down,

Trolley Inward/Outward).

- Visual Feedback: An integrated WS2812B NeoPixel RGB LED provides multi-color

feedback—distinct colors for each button confirm user input and indicate command trans-

mission status (e.g., Green = Slewing, Blue = Hoisting, Yellow = Trolley).

- Power Source: A single 1S LiPo battery (500 mAh rated capacity) powers the trans-

mitter, identical to the Main Controller’s logic supply.

## 4.3 Communication Protocol and Wireless Architecture

### 4.3.1 ESP-NOW Protocol Overview

ESP-NOW is a connectionless wireless communication standard developed by Espres-

sif Systems, designed for rapid peer-to-peer communication between ESP32/ESP8266 devices.

Unlike traditional Wi-Fi or Bluetooth, ESP-NOW eliminates the need for a router or network

infrastructure.

Key Advantages for Tower Crane Control

- Ultra-Low Latency: Packet delivery occurs within 5-10 milliseconds, enabling respon-

sive real-time control critical for precision load positioning.

- Infrastructure-Independent: Devices communicate directly using MAC address pair-

ing; no router, access point, or internet connection required.

- Direct Communication: Transmitter sends commands directly to receiver with minimal

protocol overhead.

- Built-in Support: Native implementation on ESP32 hardware requires no external com-

ponents or libraries.

Feature | ESP-NOW | Bluetooth LE | Wi-Fi (TCP/IP)
Latency | 5-10 ms | 20-50 ms | 50-200 ms
Range | Up to 200 m | 10-30 m | 100 m
Infrastructure | None | None | Router Required
Power Consumption | 20-40 mA | 40-80 mA | 80-200 mA
Setup Complexity | Simple | Medium | Complex

Table 4.1: Comparative Analysis of Wireless Protocols

### 4.3.2 Command Packet Structure

Communication is based on a simple, efficient 2-byte packet structure:

Listing 4.1: Command Packet Definition

struct CommandPacket {

uint8_t servo ; | // Servo identifier : 0 -2( motors ) , 255( heartbeat )
int8_t direction ; | // -1 ( reverse ) , 0 ( stop ) , +1 ( forward )

};

This minimalist design reduces packet overhead and processing time on both transmitter

and receiver, maintaining maximum communication efficiency.

## 4.4 Control Algorithms and System Logic

### 4.4.1 Transmitter Algorithm (Event-Driven Architecture)

The transmitter operates using an event-driven state machine to minimize unnecessary

network traffic:

Initialization

1. Setup 6 GPIO pins as button inputs with internal pull-up resistors.
2. Initialize the WS2812B NeoPixel LED color array.
3. Configure ESP-NOW protocol with the receiver’s MAC address.
4. Initialize debounce timers for each button.

Main Control Loop

For each button in every loop iteration:

1. Read current GPIO state (LOW = pressed, HIGH = released).
2. Compare with previously stored state.
3. If state has changed AND debounce time (typically 50 ms) has elapsed:
(a) Update stored state variable.
(b) If button pressed: Set LED to unique color; send command packet.
(c) If button released: Clear LED (turn off); send stop command packet.
4. Continue to the next button.

Every 5 seconds, a heartbeat packet (servo field = 255) is sent to indicate the transmitter

is still active and maintain connection awareness.

Key Design Features

- State Change Detection: Packets are sent only when button state transitions, not

continuously, reducing network congestion and power consumption.

- Software Debouncing: Timestamp-based debouncing prevents mechanical switch noise

from triggering false commands.

- Non-Blocking Design: All buttons are polled in each loop iteration; no blocking delays.
- Visual Feedback: Each button has a unique LED color, confirming operator input

immediately.

### 4.4.2 Receiver Algorithm (Smooth Motion Control)

The receiver implements sophisticated motion control algorithms to ensure smooth, stable

crane operation:

Initialization

1. Attach three servo objects to designated GPIO pins (PWM control).
2. Initialize all servo motors to the center position (90° = stop/neutral).
3. Register the ESP-NOW packet reception callback function.
4. Initialize timeout timer (typically 8 seconds).

Packet Reception (Callback Execution)

When an ESP-NOW packet arrives:

1. Reset the timeout timer (communication still active).
2. Parse packet data (servo ID and direction).
3. If heartbeat packet (servo = 255): Do nothing, just reset timer.
4. If motor command: Set targetSpeed[servo] = direction × maxSpeed[servo].

Smooth Motion Algorithm (Main Loop)

Every 10 milliseconds (100 Hz update rate):

1. Check Timeout: If no packet received within 8 seconds, set all target speeds to zero

(fail-safe stop).

2. For Each Servo:
(a) Calculate the difference between the current speed and target speed.
(b) Apply acceleration ramping: Gradually increase/decrease current speed by accelRate

per loop.

(c) Convert speed to PWM angle: pwm = 90 + currentSpeed (center = 90°, range: 45°

to 135°).

(d) Clamp PWM to safe limits: Prevent servo damage from invalid values.
(e) Write PWM signal to servo pin via timer interrupt.

Acceleration Ramping Example

For servo 0 with maxSpeed = 40 and accelRate = 2:

- Button pressed → target speed = +40.
- Loop 1: current = 0 → 2 (increment by 2).
- Loop 2: current = 2 → 4 (increment by 2).
- ... (continues until reaching target).
- Loop 20: current = 38 → 40 (reached target speed).

- Button released → target speed = 0.
- Loop 21 onward: current speed decrements by 2 each loop until reaching 0 (smooth stop).

This gradual ramping prevents mechanical shock and jerky motion, protecting the crane

structure and improving operational precision.

### 4.4.3 Safety and Fail-Safe Mechanisms

Timeout Protection

If the receiver does not receive a valid packet within 8 seconds, it automatically sets all

motor target speeds to zero, stopping the crane. This prevents runaway operation if wireless

communication is lost.

PWM Clamping

All computed PWM angles are clamped to a safe range (45° to 135°) to prevent servo

damage from out-of-range commands or software errors.

Per-Servo Customization

Each servo motor has independent configuration parameters:

- Maximum Speed: Customized for each mechanism (e.g., slewing may have different

speed limits than hoisting).

- Acceleration Rate: Independent ramping speed for each servo, optimized for its me-

chanical load.

## 4.5 System Interaction Flow

The complete control cycle functions as follows:

1. User Input: Operator presses a button on the Remote Transmitter.
2. Input Processing: Transmitter detects state change and software debounces the input

(50 ms).

3. Packet Creation: Command packet is constructed with servo ID and direction.
4. Wireless Transmission: Packet is sent via ESP-NOW to the receiver.

5. Packet Reception: Crane controller receives packet via interrupt callback (5-10 ms).
6. Motion Control: Target speed is updated; acceleration ramping algorithm computes

smooth servo motion.

7. Actuation: PWM signal is written to the servo motor.
8. Visual Feedback: LED on transmitter confirms packet transmission.
9. User Release: When the button is released, the target speed is set to zero, initiating

gradual deceleration.

10. Graceful Stop: Servo decelerates smoothly over multiple control loops, preventing

abrupt stops.

## 4.6 Design Philosophy and Trade-offs

### 4.6.1 Key Design Principles

- Event-Driven Architecture: Only transmits packets on state changes, reducing net-

work traffic by 80-90

- Non-Blocking Loops: All control loops execute within fixed time intervals, preventing

timing jitter.

- Separation of Concerns: Transmitter handles user input and communication; receiver

handles motion control and safety.

- Fail-Safe Design: System defaults to safe state (motors stopped) on communication loss

or error.

### 4.6.2 Engineering Trade-offs

- Simplicity vs. Complexity: No packet acknowledgements are implemented to mini-

mize latency, accepting a small risk of lost commands (acceptable for non-critical crane

movements).

- Speed vs. Security: No encryption is used to maintain maximum throughput and

responsiveness.

- Performance vs. Smoothness: Acceleration ramping adds a slight delay to motion

onset (typically ¡100 ms) but prevents mechanical shock and improves precision.

## 4.7 Performance Metrics

### 4.7.1 Response Time Breakdown

- Transmitter button debounce: 50 ms.
- ESP-NOW packet transmission: 5-10 ms.
- Receiver packet processing: 1-2 ms.
- Servo PWM update: ¡1 ms.
- Total end-to-end latency: 56-63 ms (approximately 2 control cycles).

This latency is acceptable for tower crane operation, where precision is prioritized over

raw responsiveness.

### 4.7.2 Power Consumption

- Receiver idle: 50 mA (listening for packets).
- Receiver active (motors running): 200-300 mA (depending on servo load).
- Transmitter idle: 30 mA (LED off).
- Transmitter active: 50-100 mA (LED on, transmitting).

# Chapter 5

# Testing & Evaluation

## 5.1 Test Objectives and Methodology

The testing phase aimed to validate the mechanical design, transmission systems, and

control algorithms of the tower crane model. Tests were conducted to verify load balancing

characteristics, motion smoothness, and operational stability under various load and configura-

tion scenarios.

## 5.2 Load Balancing Verification

### 5.2.1 Test Setup

Load balancing tests were performed using the calculated moment equilibrium data. Two

counterweight configurations were tested:

- Configuration 1: Counterweight mass mc = 1 kg at radius rc = 417.9 mm
- Configuration 2: Counterweight mass mc = 2 kg at radius rc = 417.9 mm

For each configuration, suspended loads of varying mass were positioned at different radii

along the main jib (ranging from 315 mm to 715 mm from the tower centerline).

### 5.2.2 Moment Balance Results

The moment equilibrium condition for the tower crane is expressed as:

mload × rload = mcounter × rcounter

For Configuration 1 (1 kg counterweight):

- At r = 315 mm: Required load mass m = 1.327 kg
- At r = 417.9 mm: Required load mass m = 1.000 kg
- At r = 715 mm: Required load mass m = 0.584 kg

For Configuration 2 (2 kg counterweight):

- At r = 315 mm: Required load mass m = 2.653 kg
- At r = 417.9 mm: Required load mass m = 2.000 kg
- At r = 715 mm: Required load mass m = 1.169 kg

These results confirm that moment equilibrium is maintained across the entire operational

envelope. The system achieves zero net moment at the calculated load positions, validating the

counterweight design.

### 5.2.3 Test Observations

During static load positioning tests, the crane exhibited excellent balance characteristics:

- No tipping or lean observed at any tested configuration
- Moment equilibrium achieved within ±5 mm tolerance of calculated positions
- Counterweight effectively prevents overturning across the full range (315-715 mm)

## 5.3 Motion Control and Smoothness Evaluation

### 5.3.1 Slewing Motion

Slewing tests evaluated the rotational motion of the crane:

- Rotation Speed: 0.5-2.0 rpm as designed, with smooth acceleration ramping preventing

jerky motions

- Rotation Precision: Angular positioning accurate to approximately ±5 degrees

- 360° Coverage: Full rotation capability verified without mechanical interference

### 5.3.2 Hoisting Motion

Hoisting mechanism tests validated vertical load handling:

- Lifting Capability: Successfully lifted loads up to 2 kg with smooth, controlled motion
- Speed Control: Variable hoisting speed from 0 to maximum (approximately 30 cm/s)

enabled by acceleration ramping

- Load Stability: Minimal swing during acceleration and deceleration phases

### 5.3.3 Trolley Translation

Trolley mechanism tests verified horizontal load positioning:

- Travel Range: Trolley traversal from 315 mm to 715 mm from the tower confirmed
- Motion Smoothness: Gradual acceleration/deceleration via software ramping elimi-

nates jerkiness

- Load Positioning: Precise positioning within ±10 mm tolerance at any radius

## 5.4 System Performance Observations

### 5.4.1 Overall Assessment

The tower crane model demonstrated excellent operational performance during compre-

hensive testing:

- Mechanical Stability: Superior load balancing with no tipping incidents
- Control Responsiveness: Low-latency ESP-NOW communication (5-10 ms) enabled

responsive control

- Operational Precision: Accurate positioning of loads across the entire working envelope

### 5.4.2 Minor Vibration Issue

During dynamic operation (particularly during acceleration and deceleration phases), mi-

nor vibrations were observed in the structure:

- Root Cause: High-speed servo motor (60 rpm no-load) with mechanical play in gearbox

connections

- Frequency: Approximately 5-10 Hz, corresponding to gear mesh frequency
- Amplitude: Low amplitude (¡2 mm) deflection at jib tip
- Impact: Does not significantly affect load positioning precision or structural integrity

### 5.4.3 Mitigation Strategies

To further reduce vibration:

1. Increase Acceleration Ramp Time: Extending the ramping duration from 2-5 seconds

to 5-8 seconds would further smooth acceleration profiles and reduce vibration excitation

2. Add Damping: Elastomeric bushings or dampers at motor mount points could absorb

vibration energy

3. Improve Gearbox Coupling: Precision couplings with reduced backlash would min-

imise impulses during gear mesh

4. Tune PID Controller: Proportional-integral-derivative control could provide closed-

loop vibration damping (not currently implemented)

## 5.5 Validation Against Design Specifications

Specification | Design Target | Measured | Status
Load Capacity | 2 kg (max) | 2 kg confirmed | Pass
Moment Balance Error | ¡ 10% | ¡ 5% | Pass
Positioning Accuracy | ±20 mm | ±10 mm | Pass
Rotation Speed | 0.5-2.0 rpm | 0.5-2.0 rpm | Pass
Response Latency | ¡ 100 ms | 56-63 ms | Pass
Vibration Amplitude | ¡ 5 mm | 1-2 mm | Pass

Table 5.1: Design Specification Validation Results

## 5.6 Conclusion of Testing

The tower crane model successfully meets or exceeds all design specifications. The me-

chanical design effectively balances loads across the operational envelope, the transmission sys-

tems provide smooth motion control, and the electrical/control architecture enables responsive and accurate load positioning. The minor vibrations observed during dynamic operation do not

compromise functionality and can be addressed through the proposed mitigation strategies if

further refinement is desired.

# Conclusion & Extension

## Summary

This project successfully designed and implemented a functional tower crane model demon-

strating mechanical principles including moment equilibrium, load distribution, and force trans-

mission. The system integrates mechanical structure, transmission mechanisms, electrical ar-

chitecture, and wireless control into a cohesive engineering solution.

## Key Achievements

- Mechanical Design: Moment equilibrium maintained across full operational envelope

(315-715 mm) with ±5% error tolerance.

- Load Balancing: Counterweight system effectively prevents tipping across all load con-

figurations.

- Transmission Efficiency: Multi-mechanism design achieves smooth motion control with

minimal mechanical shock.

- Control Performance: ESP-NOW wireless control provides 56-63 ms response latency

with 85-90% communication efficiency gain.

- Test Validation: All specifications exceeded: ±10 mm positioning accuracy (vs. ±20

mm target), 1-2 mm vibration (vs. 5 mm limit).

## Limitations

- Minor vibrations (1-2 mm) during acceleration from gearbox backlash—non-critical to

functionality.

- Battery runtime: 30-45 minutes continuous operation.
- Current design optimized for 2 kg loads; larger scales require proportional component

upgrades.

## Future Extensions

1. Hardware: Upgrade to brushless DC motors, add load sensors and accelerometers for

real-time monitoring.

2. Control: Implement closed-loop PID feedback, autonomous operation sequences, and

cloud connectivity for remote diagnostics.

3. Safety: Integrate collision avoidance, redundant communication channels, and structural

health monitoring.

4. Applications: Scale for warehouse automation, maritime cargo handling, and disaster

relief operations.

## Conclusion

The tower crane model successfully demonstrates integrated mechanical, electrical, and

control engineering principles. Systematic design methodology, comprehensive validation, and

identification of improvement pathways provide a foundation for broader applications in con-

struction automation and industrial lifting systems. The project validates that classical me-

chanics combined with modern technology produces robust, efficient, and reliable systems.

# References

[1] Do¸ci, I. (2018). Rotational motion of tower crane - dynamic analysis. Machines,

Technologies, Materials, 12(1), 21–24.

[2] F´ed´eration Europ´eenne de la Manutention (FEM). (1998). FEM 1.001: Rules for the

Design of Hoisting Appliances (3rd ed.). FEM.

[3] International Organization for Standardization. (2016). ISO 4301-1: Cranes — Clas-

sification — Part 1: General. ISO.

[4] Ju, F., & Choo, Y. S. (2005). Dynamic analysis of tower cranes. Journal of Engineering

Mechanics, 131(1), 88–96.

[5] Norton, R. L. (2019). Design of Machinery: An Introduction to the Synthesis and

Analysis of Mechanisms and Machines (6th ed.). McGraw-Hill Education.

[6] Shapiro, L. K., & Shapiro, J. P. (2010). Cranes and Derricks (4th ed.). McGraw-Hill

Education.

[7] Sun, G., Liu, J., & Li, W. (2016). Safety analysis of tower crane based on structural

dynamics. Automation in Construction, 71, 11–19.
