pacman314159/3D-Printed-Crane-System-HCMUT/3d files/Crane_Assembly.step

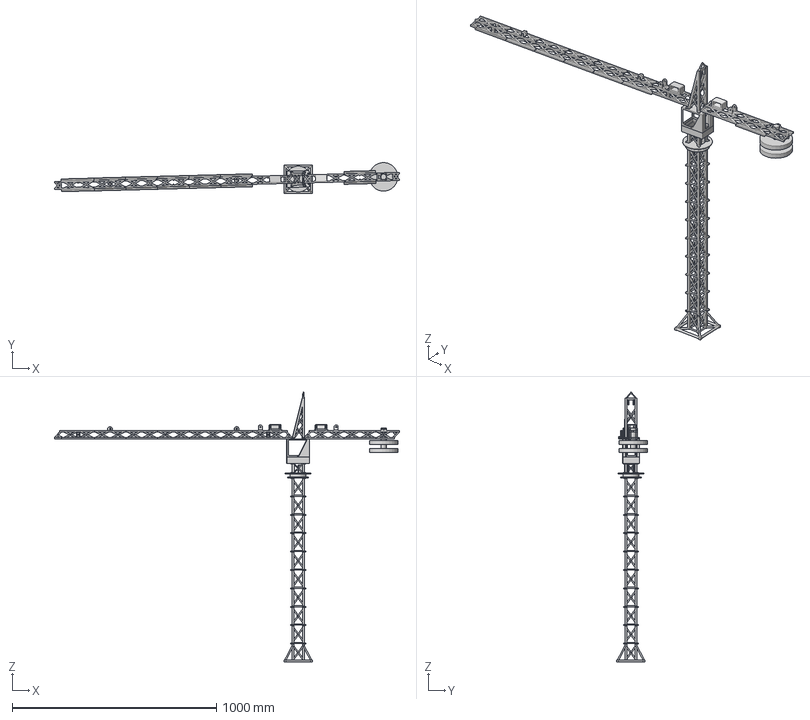
[picture p26: CAD file, 2025-12-02]
3d files/Crane_Assembly.step
1688.4 x 150.7 x 1320.9 mm
Base
Tower_Section x 9
Slewing_Unit_bottom
Slewing_Unit_top
tnig
Slew_Top_Section
Crane_Cabin
Crane_Top
Top_tingamabob
Jib_Base x 2
Jib_pulley x 2
Jib_String x 2
Jib_End
PULLEY BAT
Jib_Counterweight_end
Counterweight
Jib_Connector - PULLEY
PULLEY BAT_1
PULLEYDAY
de dây
cuonday
Servo Motor
PULLEYSERVO
mount
servo holder
Jib_Connector - PULLEY_1
PULLEYDAY_1
de dây_1
cuonday_1
Servo Motor_1
PULLEYSERVO_1
mount_1
servo holder_1
