pacman314159/3D-Printed-Crane-System-HCMUT/main_controller/schematic.pdf

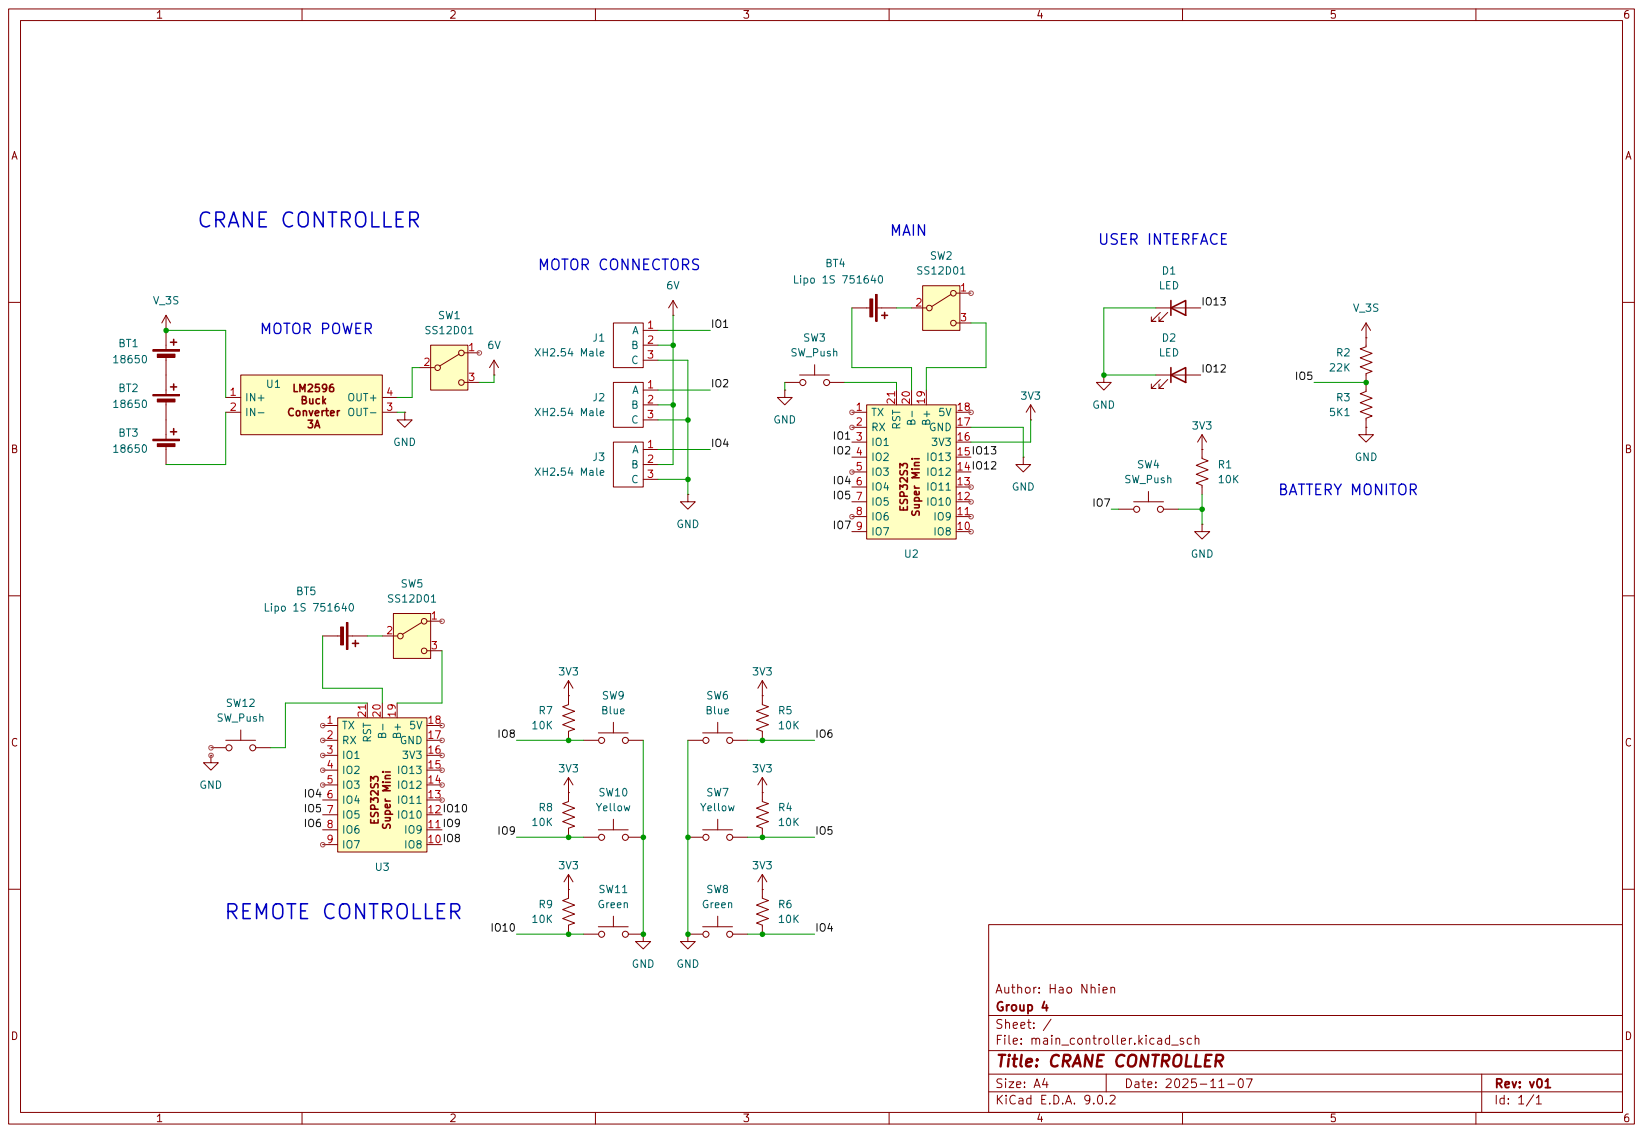
[picture p27: page 1]
